DakotaWolfi/collar-pet/esp32/README.md

# CollarPet ESP32-S3 Coprocessor Firmware

Latest synced firmware source from:

- `temp resurces/current/ESP32-s3 coprocessor/CollarPet_ESP32S3_v2_4_HotPlug_PPG`

## Firmware file

- `CollarPet_ESP32S3_v2_4_HotPlug_PPG.ino`

Use Arduino IDE or PlatformIO with ESP32-S3 board support to build/flash.
