DakotaWolfi/collar-pet/docs/HARDWARE_STATUS.md

# Hardware status

CollarPet is currently between proof-of-concept hardware and a proper integrated PCB revision.

The current physical build still relies heavily on development boards, perfboard, wiring and stacked modules. It proves the architecture, but it urgently wants to become a proper PCB.

## Published files

The repository contains the current schematic PDF and EasyEDA source/design files that are suitable for public distribution.

## Open-hardware licensing direction

The intended hardware license is CERN Open Hardware Licence Version 2 — Strongly Reciprocal (`CERN-OHL-S-2.0`).

Third-party artwork is not part of the open-hardware source. Eurofurence 31 silkscreen artwork used on a private prototype revision is being removed from public hardware files rather than being relicensed without permission.

The goal is for the published PCB source to contain only material that can legitimately be distributed under the selected hardware license.

## Current prototype photos

These photos document the current development hardware and mechanical assembly. They show rough prototype construction, not a finished enclosure or production PCB.

Overall sensor/display board view:

Current CollarPet sensor and display prototype

Stacking/wiring side view:

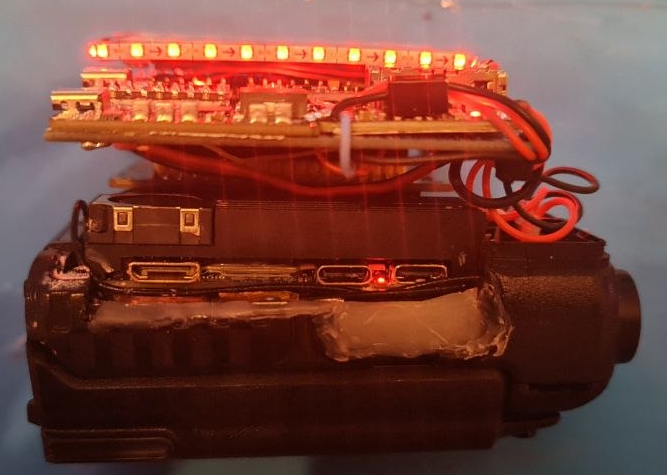
[picture p8: docs/images/prototype/collarpet-prototype-side-stack-and-wiring.png]
CollarPet prototype side stack and wiring


SBC cooling arrangement in UV-5R style donor shell:

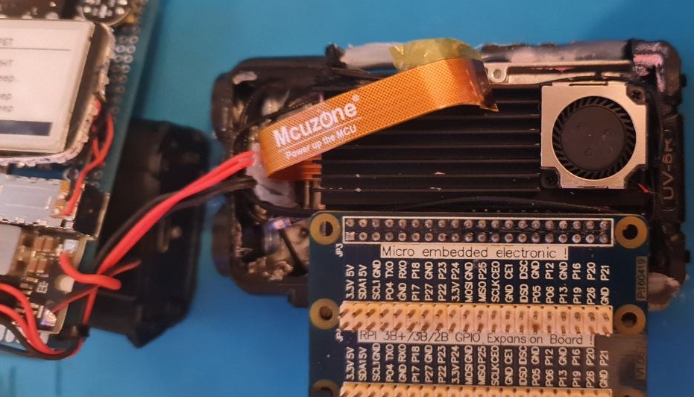
[picture p9: docs/images/prototype/collarpet-orange-pi-cooling-uv5r-shell.png]
Orange Pi cooling inside UV-5R style shell


Prototype parts layout:

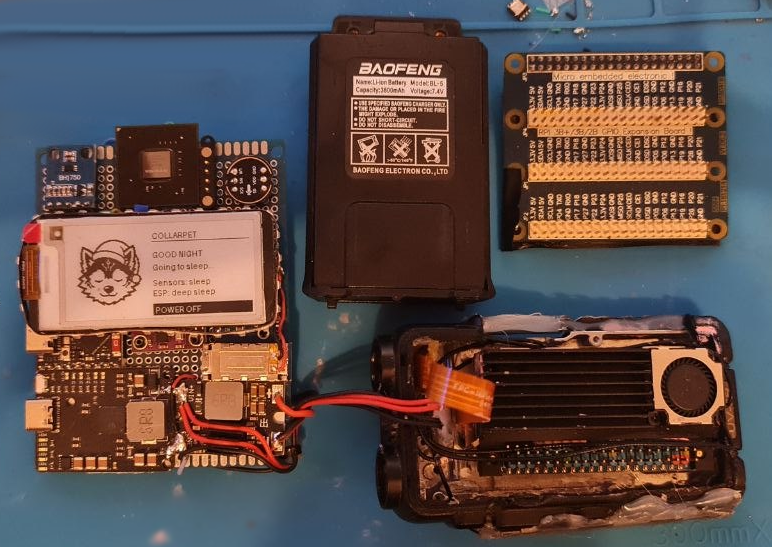
[picture p10: docs/images/prototype/collarpet-prototype-parts-layout.png]
CollarPet prototype parts layout


Technical close-up of sensor/LED/microphone area:

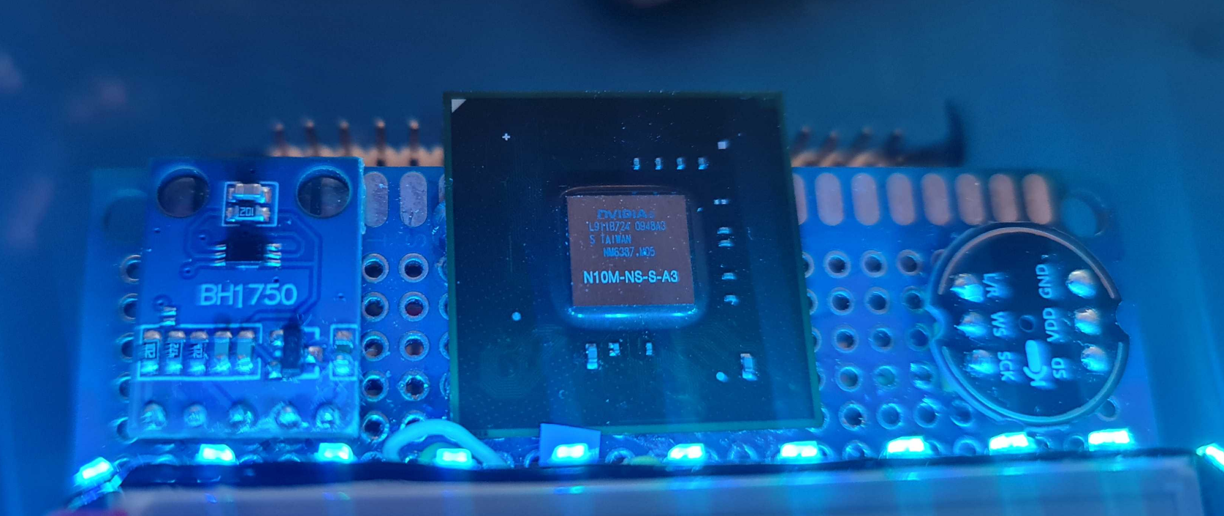
[picture p11: docs/images/prototype/collarpet-sensor-board-nvidia-bh1750-mic-closeup.png]
Sensor board close-up with BH1750 and microphone breakout


Note: the visible NVIDIA package on the prototype is a salvaged physical package detail used in prototype construction context; do not treat this image alone as evidence of an onboard functional GPU.

Development bench context (prototype + PT35 + the physically separate GPU gag component):

CollarPet bench overview with PT35 and GPU prototype gag
