DakotaWolfi/collar-pet/artifacts/README.md

# Handoff Archives

This folder stores handoff/package artifacts that were provided as release bundles.

## Included

- `CollarPet_PetMind_RealTraining_Prep_v1.zip`
  - Purpose: packaged preparation bundle for PetMind real-world training workflow
  - Source: `temp resurces/current/`

## Notes

- Treat zip artifacts as distribution snapshots.
- Prefer source files under `pi/`, `pt35/`, and `docs/` when making ongoing changes.
