DakotaWolfi/collar-pet/collarpet_photo_handoff/collarpet_photo_handoff/images/pt35-collarpet-main-ui.png

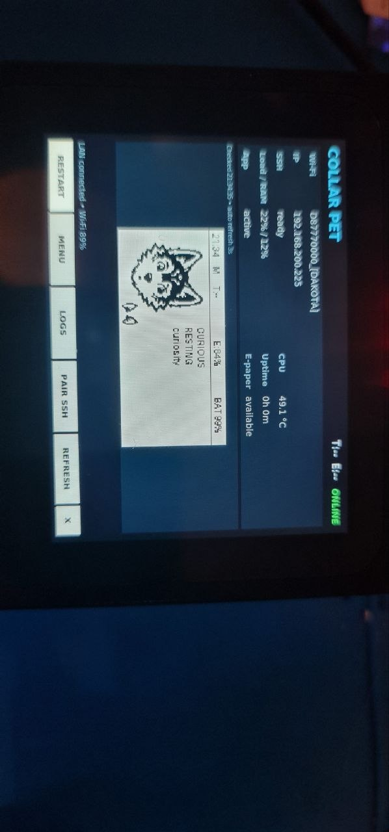
collarpet_photo_handoff/collarpet_photo_handoff/images/pt35-collarpet-main-ui.png
