DakotaWolfi/collar-pet/docs/images/collarpet-bh1750-nvidia-mic-closeup.png

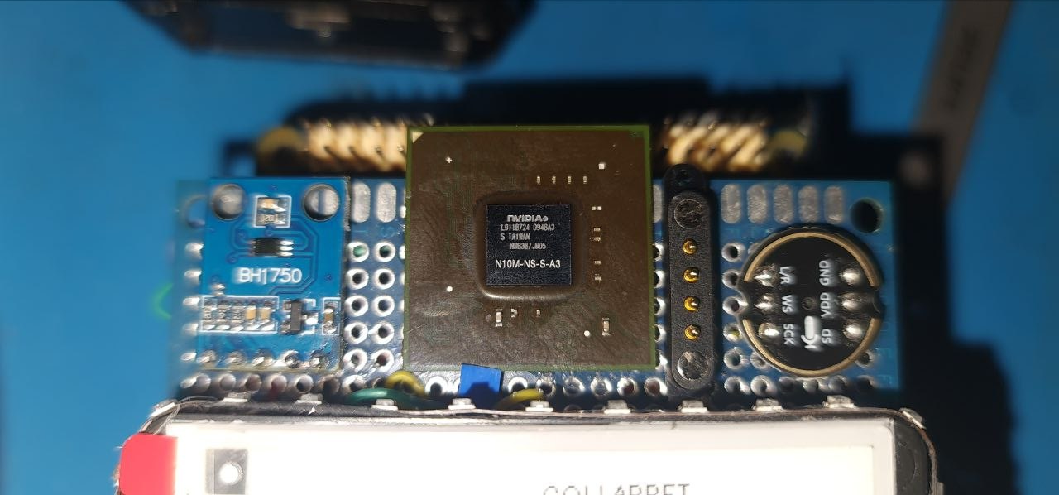
docs/images/collarpet-bh1750-nvidia-mic-closeup.png
