DakotaWolfi/collar-pet/docs/images/collarpet-overview.jpg

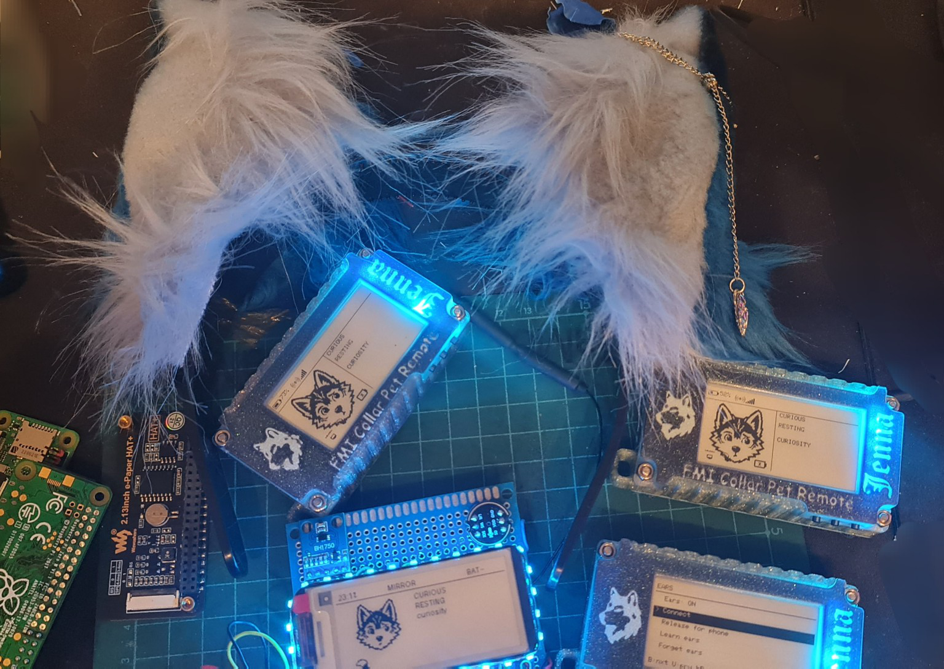
docs/images/collarpet-overview.jpg
