DakotaWolfi/collar-pet/docs/images/collarpet-sensor-board-red-led-side-closeup.png

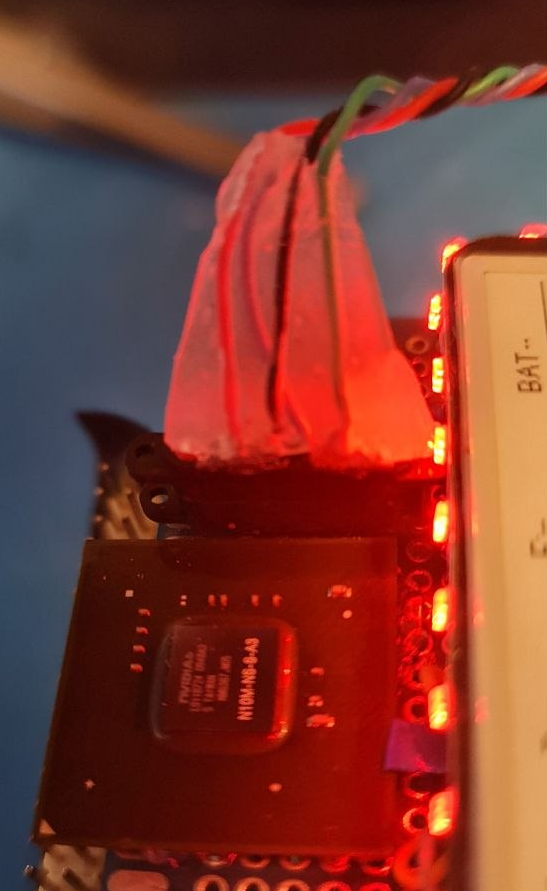
docs/images/collarpet-sensor-board-red-led-side-closeup.png
