DakotaWolfi/collar-pet/docs/images/collarpet-sensor-board-top-overview-alt.png

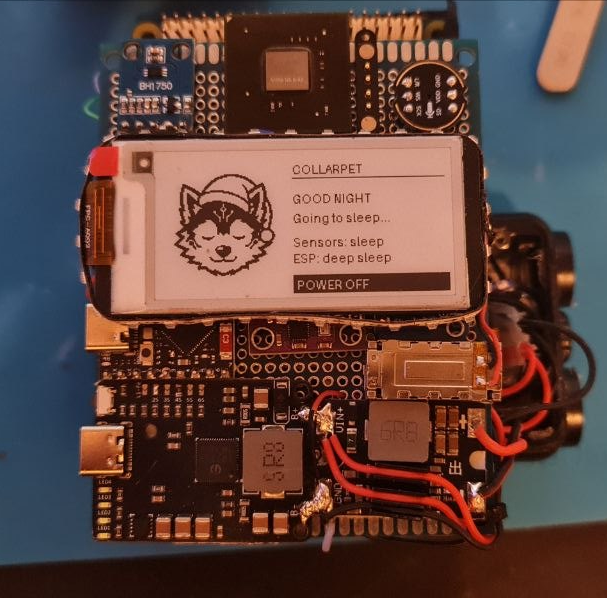
docs/images/collarpet-sensor-board-top-overview-alt.png
