DakotaWolfi/collar-pet/docs/images/collarpet-ui.jpg

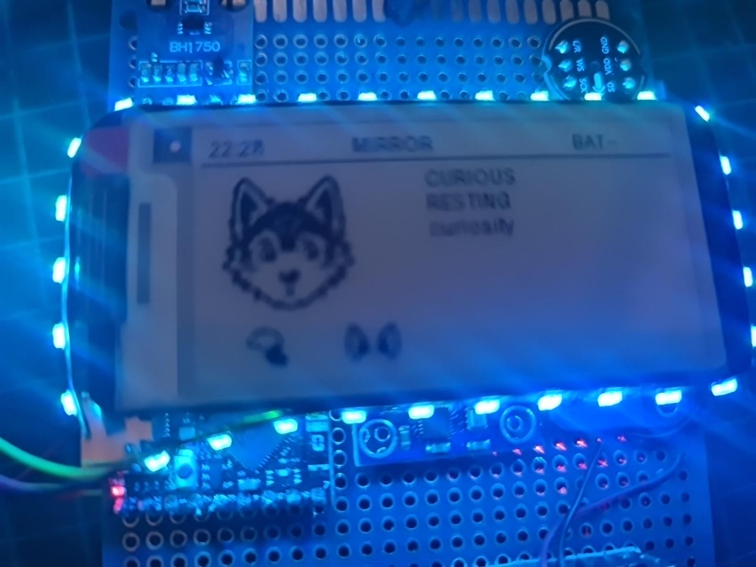
docs/images/collarpet-ui.jpg
