DakotaWolfi/collar-pet/docs/images/orange-pi-cooler.jpg

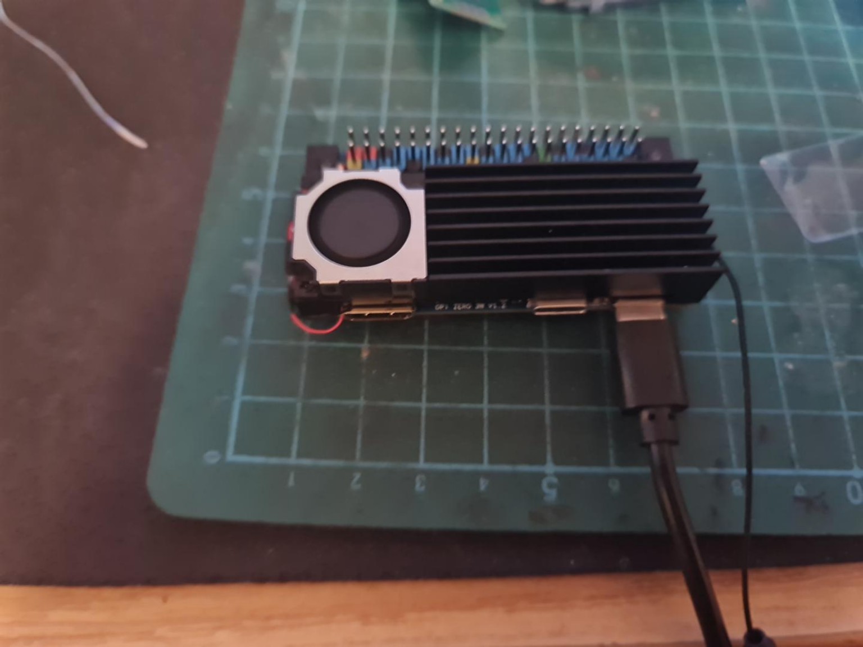
docs/images/orange-pi-cooler.jpg
