DakotaWolfi/collar-pet/pi/assets/wolves/Cybernetic Wolf Paw Emblem.png

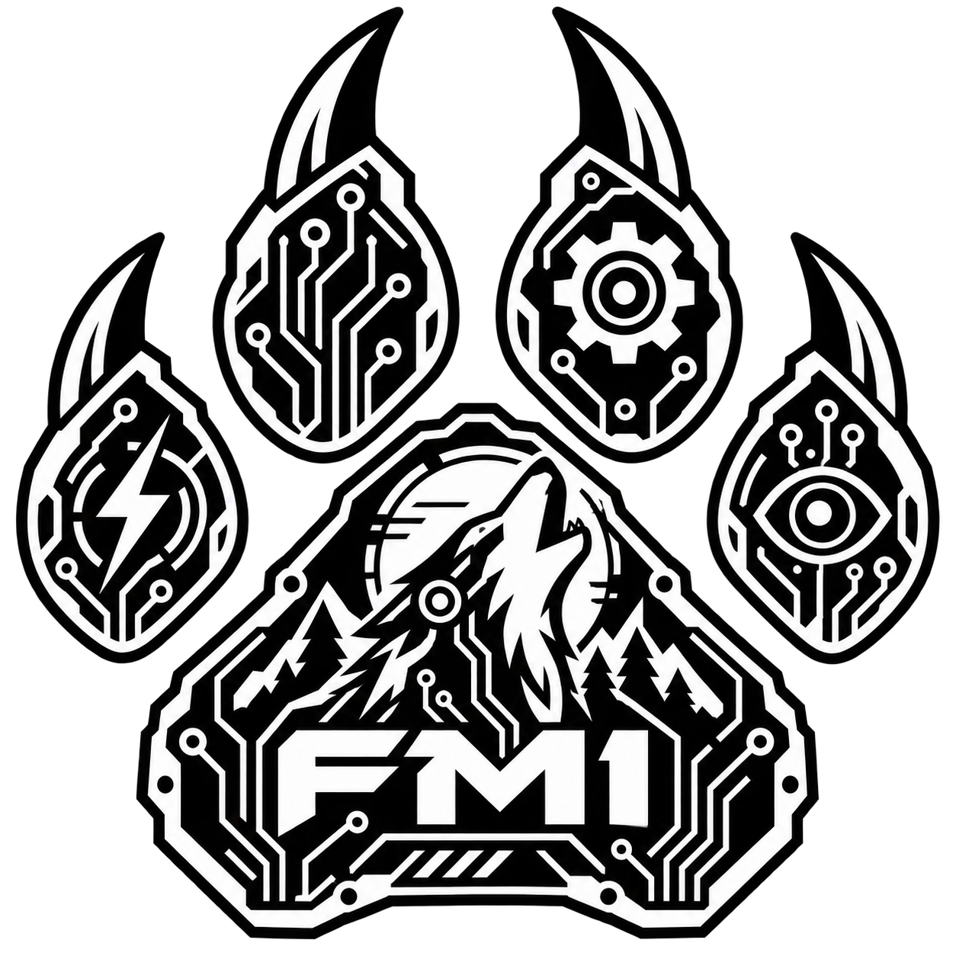
pi/assets/wolves/Cybernetic Wolf Paw Emblem.png
