DakotaWolfi/collar-pet/pi/assets/wolves/wolf_annoyed.png

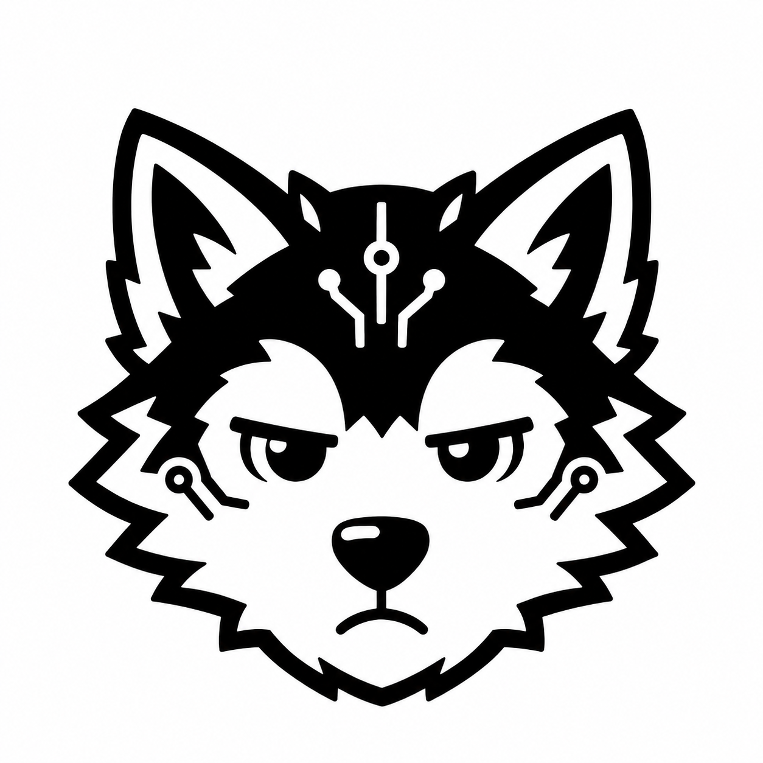
pi/assets/wolves/wolf_annoyed.png
