DakotaWolfi/collar-pet/pi/assets/wolves/wolf_curious.png

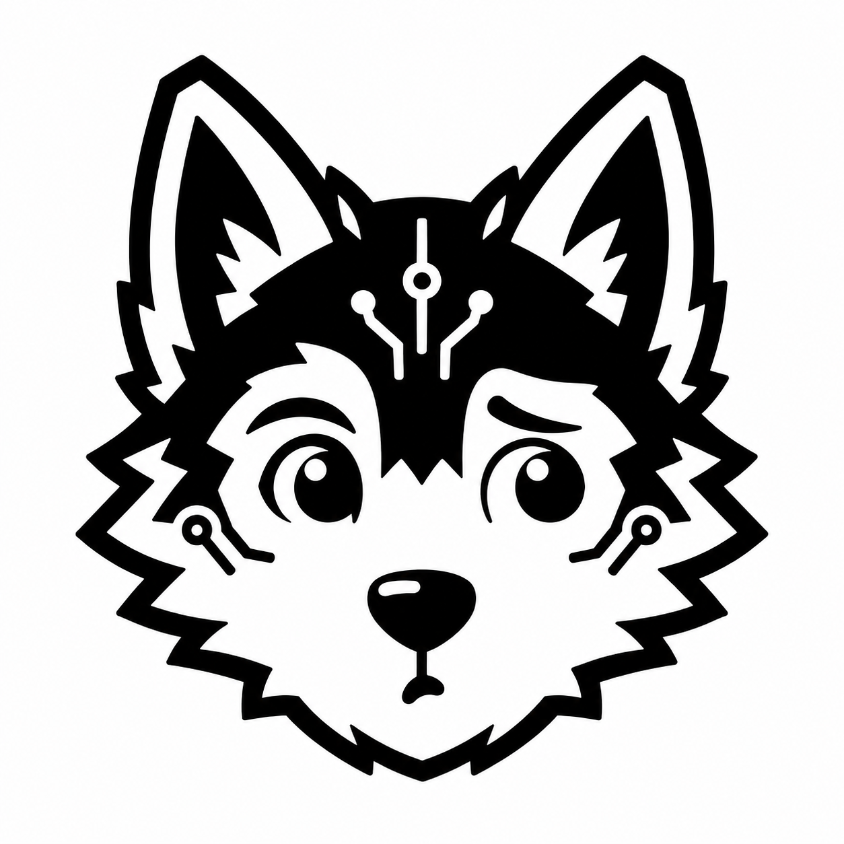
pi/assets/wolves/wolf_curious.png
