DakotaWolfi/collar-pet/pi/assets/wolves/wolf_overwhelmed.png

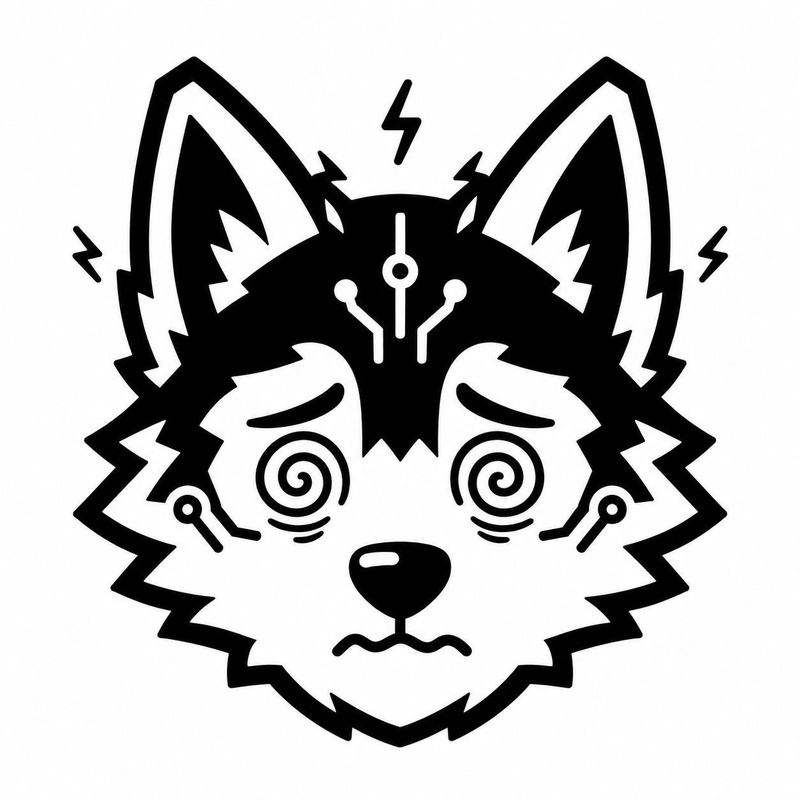
pi/assets/wolves/wolf_overwhelmed.png
