DakotaWolfi/collar-pet/pi/assets/wolves/wolf_reboot.png

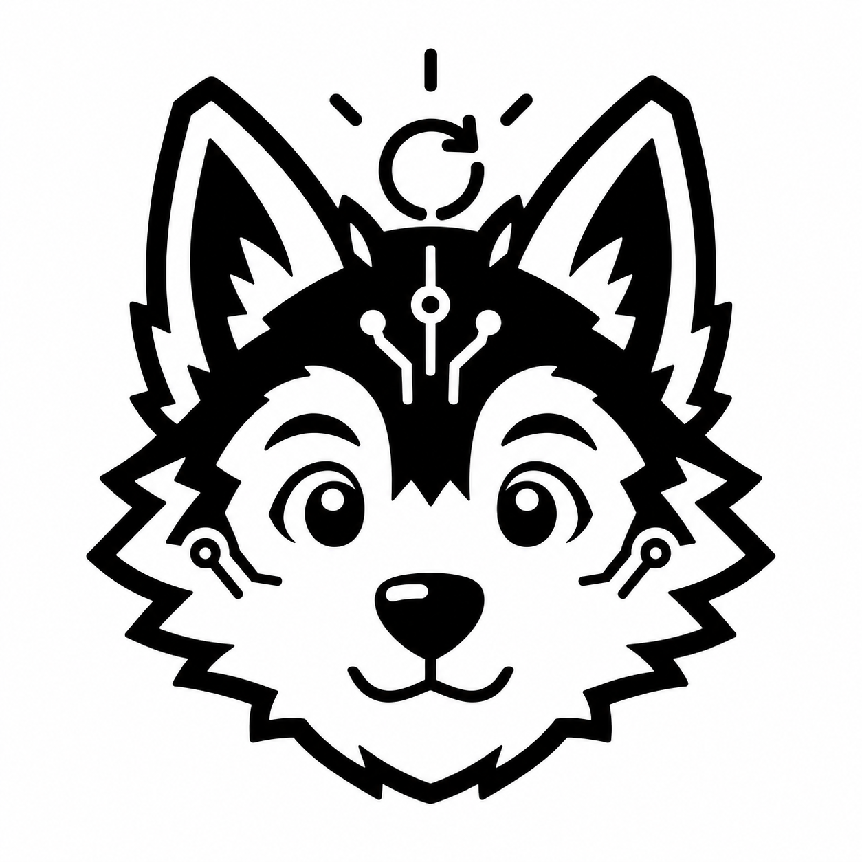
pi/assets/wolves/wolf_reboot.png
