DakotaWolfi/collar-pet/pi/assets/wolves/wolf_shutdown.png

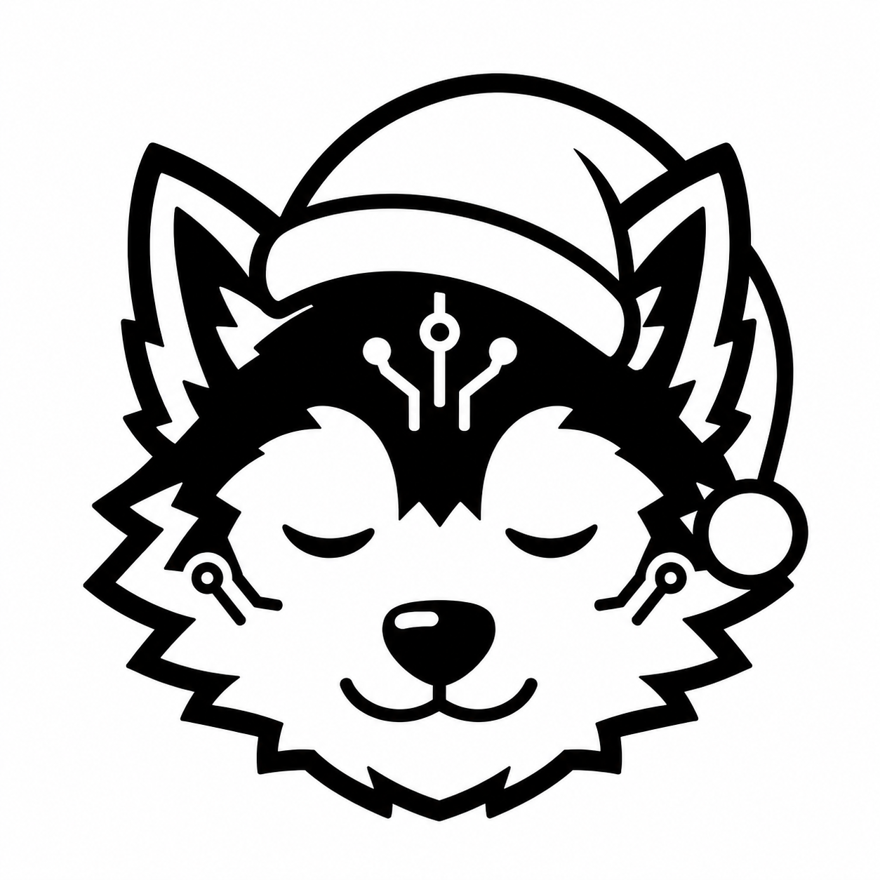
pi/assets/wolves/wolf_shutdown.png
