DakotaWolfi/collar-pet/PCB/E_Paper_LED_Adapter/PCB_e-Paper led PCB_2026-09-25.pdf

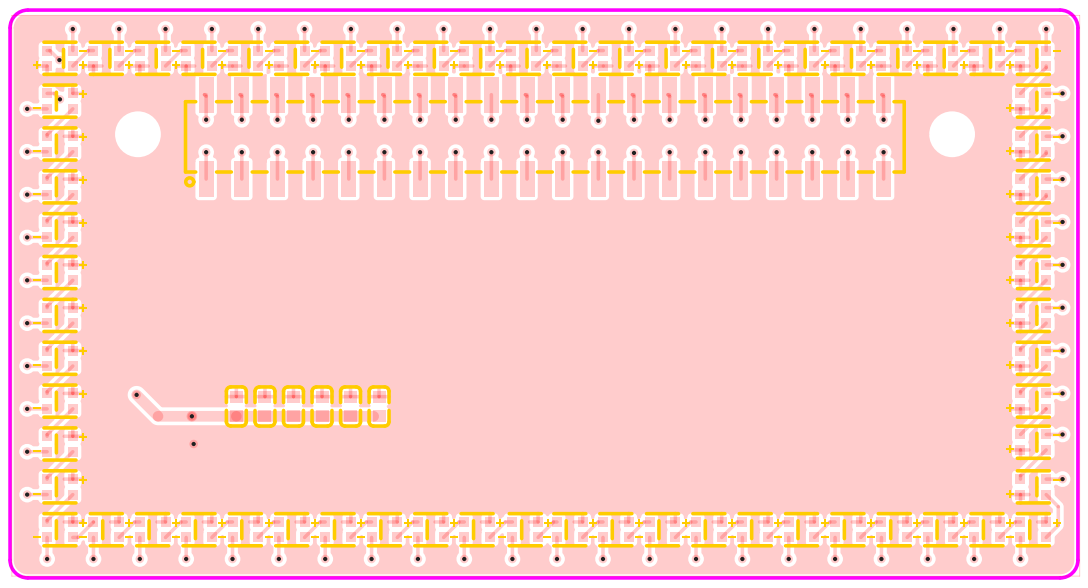
[picture p28: page 1]

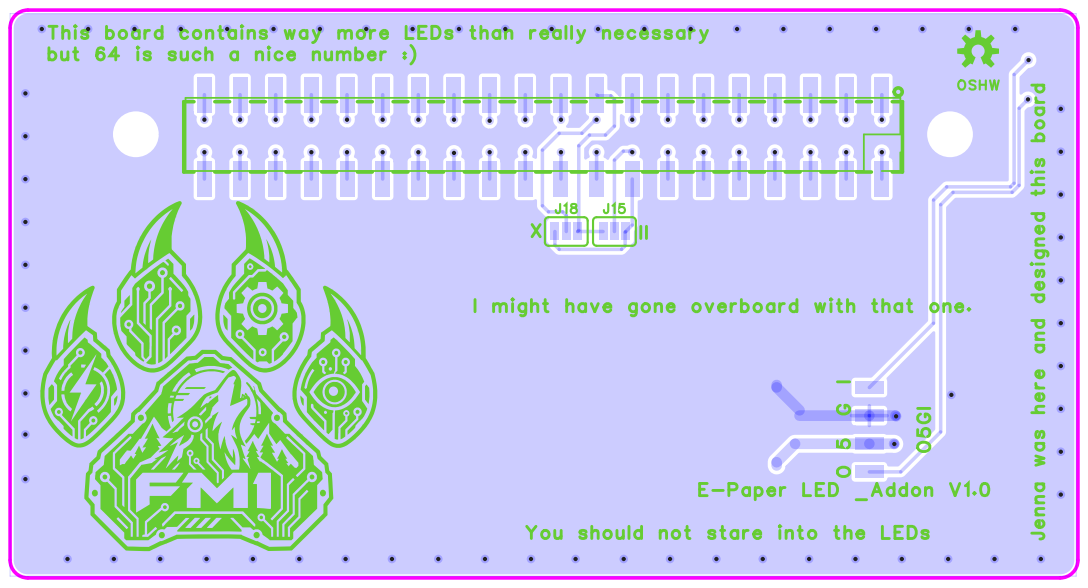
[picture p29: page 2]

This board contains way more LEDs than really necessary
but 64 is such a nice number :)

Jenna was here and designed this board

I might have gone overboard with that one.

You should not stare into the LEDs
