DakotaWolfi/collar-pet/PCB/Sensor_Hub/PCB_Sensor_Hub_v2_2026-09-25.pdf

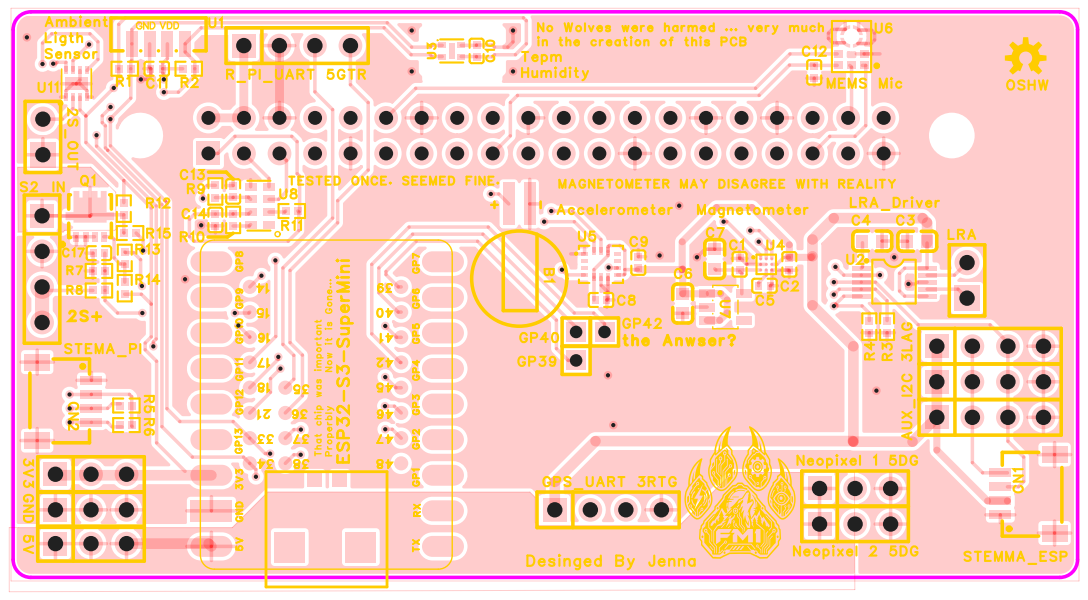
[picture p30: page 1]

No Wolves were harmed ... very much
in the creation of this PCB
Tepm
Humidity

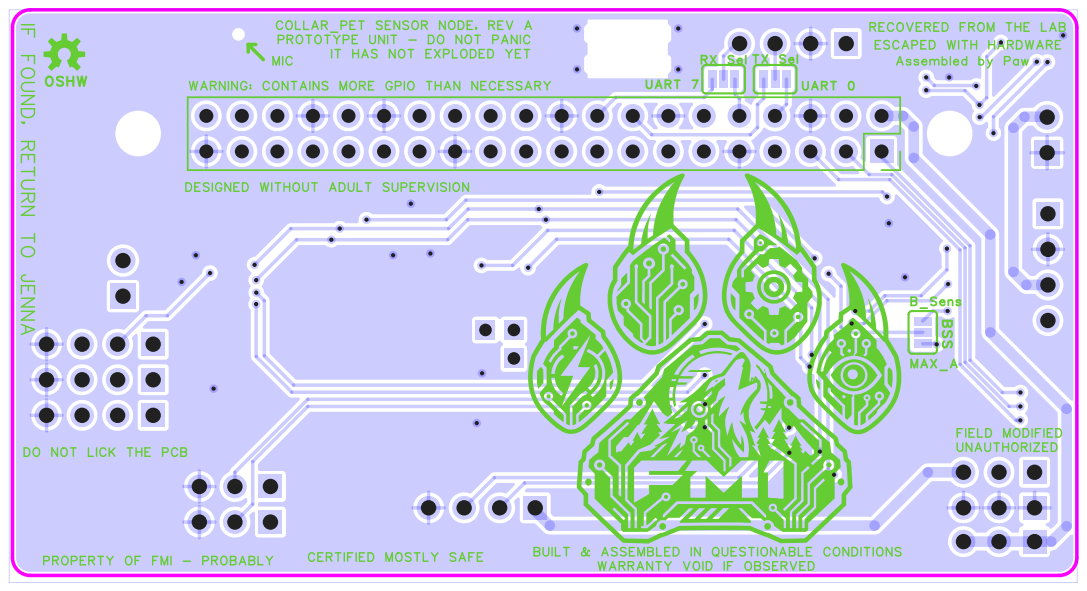
[picture p31: page 2]

IF FOUND, RETURN TO JENNA DO NOT LICK THE PCB

COLLAR_PET SENSOR NODE, REV A
ESCAPED WITH HARDWARE PROTOTYPE UNIT - DO NOT PANIC
IT HAS NOT EXPLODED YET

RECOVERED FROM THE LAB

WARNING: CONTAINS MORE GPIO THAN NECESSARY

DESIGNED WITHOUT ADULT SUPERVISION

PROPERTY OF FMI - PROBABLY

BUILT & ASSEMBLED IN QUESTIONABLE CONDITIONS

WARRANTY VOID IF OBSERVED
