DakotaWolfi/collar-pet/PCB/Sensor_Hub/SCH_Sensor Hub v2_2026-09-25.pdf

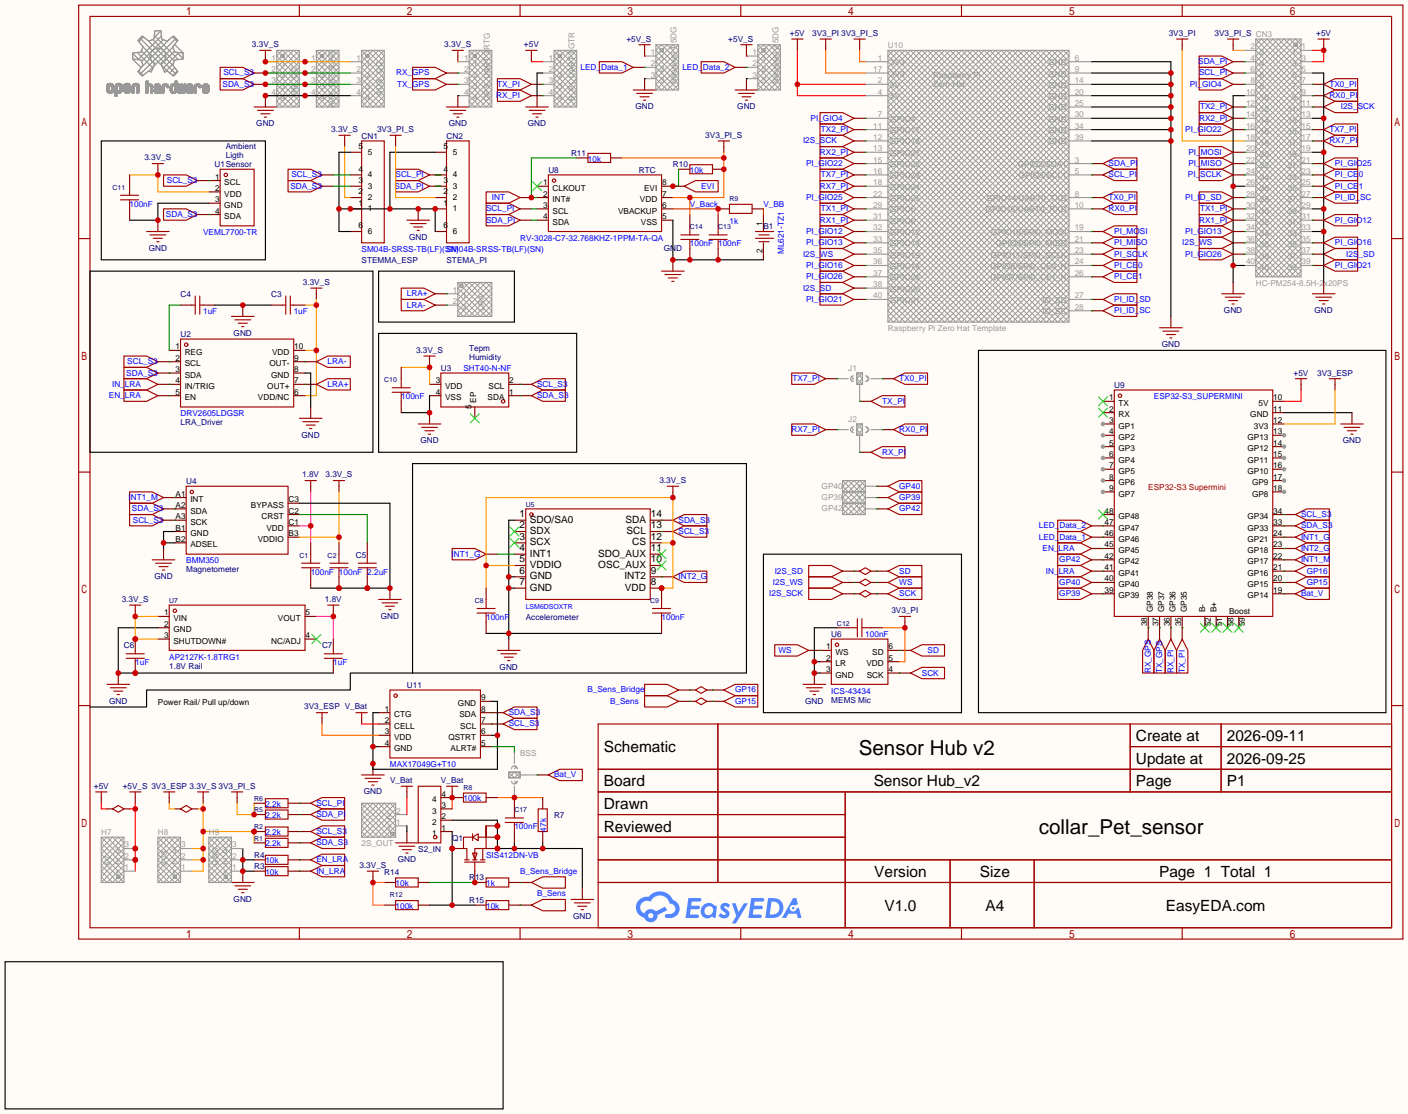
[picture p32: page 1]

Raspberry Pi Zero Hat Template

ADSEL B2 GND B1 SCK A3 SDA A2 INT A1

Power Rail/ Pull up/down

Schematic | Sensor Hub v2 | Create at | 2026-09-11

Update at | 2026-09-25

Board | Sensor Hub_v2 | Page | P1
Drawn | | collar_Pet_sensor
Reviewed

Version | Size | Page 1 Total 1
V1.0 | A4 | EasyEDA.com
