DakotaWolfi/collar-pet/PCB/Sensor_Hub/PCB_Sensor Hub PCB v2_2026-09-16 (4).pdf

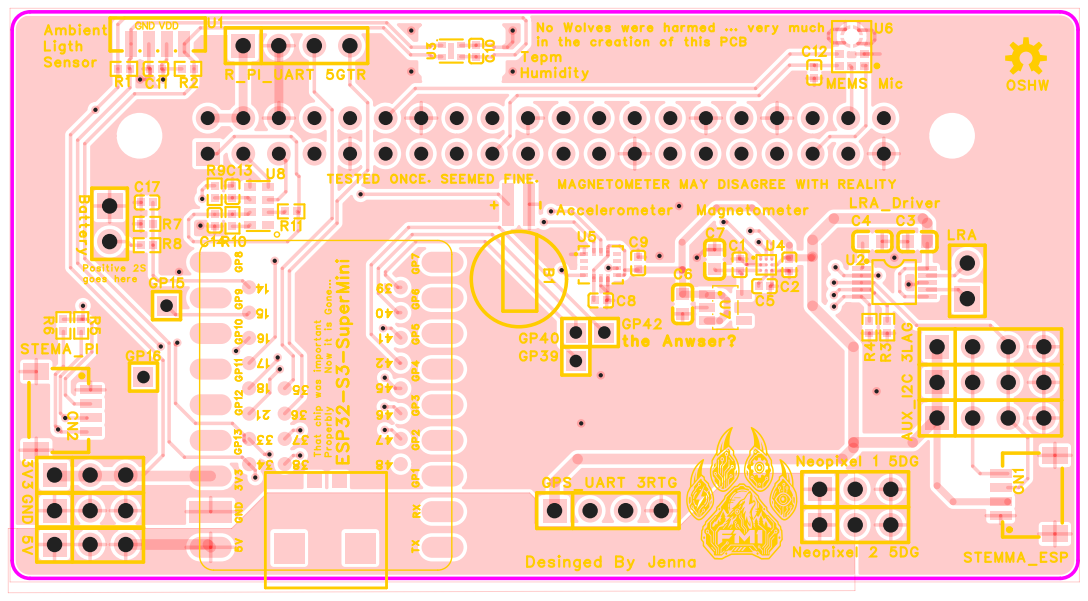
[picture p33: page 1]

No Wolves were harmed ... very much
in the creation of this PCB
Tepm
Humidity

Properbly Now it is Gone...

That chip was important

# RECOVERED FROM THE LABFIELD MODIFIED / UNAUTHORIZED

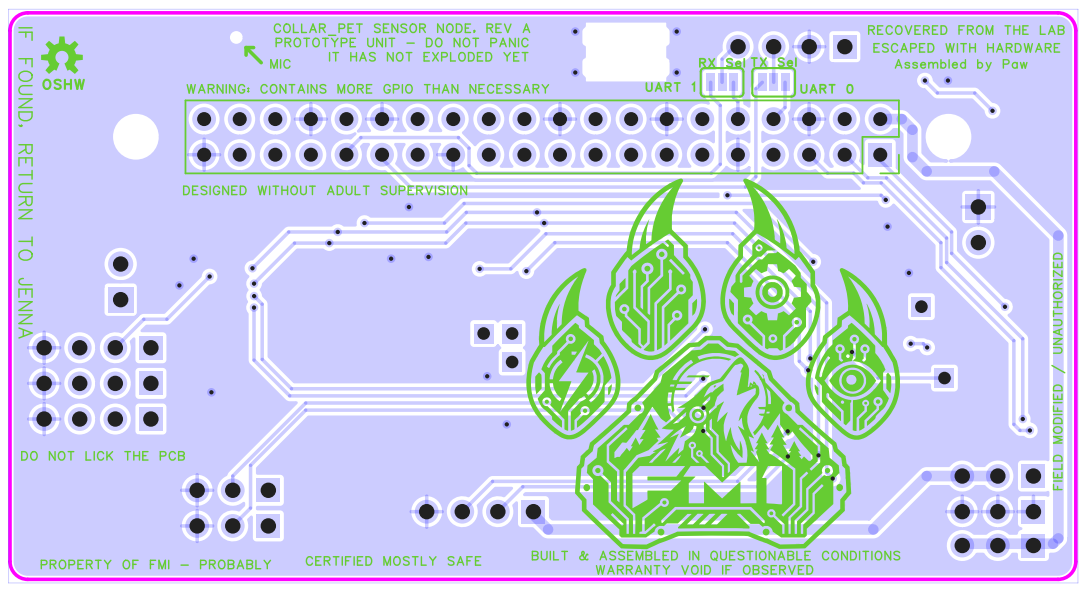
[picture p34: page 2]

IF FOUND, RETURN TO JENNA DO NOT LICK THE PCB

COLLAR_PET SENSOR NODE, REV A
ESCAPED WITH HARDWARE PROTOTYPE UNIT - DO NOT PANIC
IT HAS NOT EXPLODED YET

WARNING: CONTAINS MORE GPIO THAN NECESSARY

DESIGNED WITHOUT ADULT SUPERVISION

PROPERTY OF FMI - PROBABLY

BUILT & ASSEMBLED IN QUESTIONABLE CONDITIONS

WARRANTY VOID IF OBSERVED
