DakotaWolfi/collar-pet/(commit log)

2026-09-16 Clarify software and hardware source status in README
    Updated README to reflect public availability of software and schematics, and clarified the status of hardware source files and PCB layout.
2026-09-20 Update prototype images for improved documentation clarity
2026-09-20 Fix image paths in README.md
    Updated image paths in README to remove 'prototype' subdirectory.
2026-09-25 Refactor code structure for improved readability and maintainability
    [BOM_Sensor Hub_v2_Sensor Hub v2_2026-09-25.csv, BOM_Sensor Hub_v2_Sensor Hub v2_2026-09-25.xlsx]
2026-09-25 Add PCB design for Collar Pet Sensor Node, Rev A prototype
2026-09-25 Fix typos and improve clarity in README.md regarding GPU specifications and PCB details
